alexanderrotariu/tensileTester/README.md

# Tensile Tester 
Collection of files related to 431 Systems Analysis + Design's tensile strength project

The system will preform tensile material strength tests for the UAlbany Chemistry Dept.

The project is based off this paper : 

Fabrication of an Economical Arduino-Based Uniaxial Tensile Tester
Julien H. Arrizabalaga, Aaron D. Simmons, and Matthias U. Nollert
Journal of Chemical Education 2017 94 (4), 530-533
DOI: 10.1021/acs.jchemed.6b00639

All changes made to the original design are included in the slideshow and Physical Design.

Standalone Matlab App can be used with any .csv file format with CM and Newtons as units listed as so:
6CM , 0N
6.5CM , 0.5N
etc...

Load Slope code adapted from Professor Muckells example. 

# Upgraded Parts List
---------------------------------
[S-Type Load Cell](https://www.amazon.com/Pressure-Force-S-type-Sensor-Cable/dp/B01F6IOW6I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) - $36.99

[Push Pull Force Fixture](https://www.amazon.com/Push-Pull-Fixture-Loading-Capacity-Stainless/dp/B087LXNJ2J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) - $19.95 x 2 
 
[DC motor speed controller](https://www.amazon.com/RioRand-Controller-Efficiency-Generating-Protection/dp/B007TH4EN6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) - $9.99

[12v DC motor with wormdrive gearbox](https://www.amazon.com/dp/B01M8LL502?ref_=cm_sw_r_cp_ud_dp_KBN8Q3NMACPN06GBZWH4) - $18.43

# Software dependencies
---------------------------------
- [Arduino IDE](https://www.arduino.cc/en/software) with [ArduSpreadsheet](https://circuitjournal.com/arduino-serial-to-spreadsheet) plugin: Install both Arduino IDE and ArduSpreadsheet to begin data collection. Open the ArduSpreadsheet plugin **BEFORE** data collection begins.
- [MatLab Data Analysis App](https://github.com/alexanderrotariu/tensileTester/blob/main/Source-Code/StressStrainMatlabApp/StressStrainInstaller.exe): Helpful for analyzing data retrieved after tensile testing. This app is a **one time** install. To operate, follow on screen instructions.
