alexanderrotariu/tensileTester/Presentations/Final Presentation.pdf

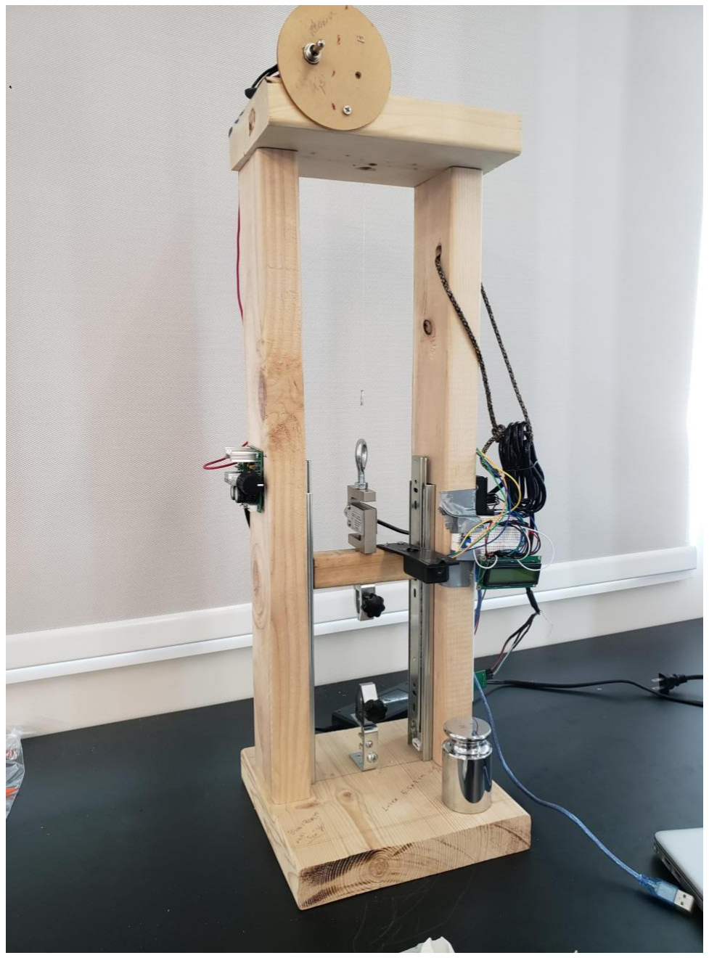
[picture p16: figure]

# Material Tensiometer

Group 8:
Jebadiah Parillo, Alexander Rotariu, Hiroaki Nakahara, Alistair Talaboc

Key Features:(the whats, whys and hows)

Ease-of-use:
- Streamlined data collection system. The device is simple to use and a sample can be taken with just 5 easy steps:
1. Connect PC/laptop via blue USB cable
2. Tighten material in clamps and follow prompts on LCD Screen
3. Toggle motor switch to begin measurements
4. Open ArduSpreadsheet and save data as csv
5. Open Stress Strain matlab app and plot the csv
- Outputs include the Stress-Strain graph, Young’s Modulus and the Ultimate Tensile Strength .
Accuracy:
- Load is automatically calibrated Arduino and then normalized again at the beginning of testing
- Average of 20 values before the device outputs load or distance.

# Budget and Expenses

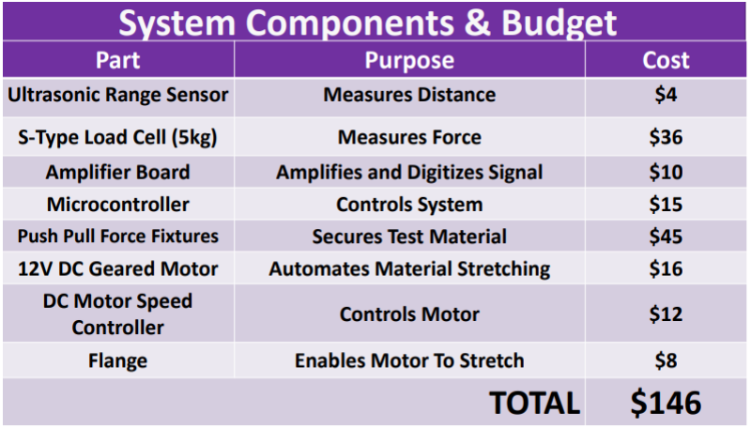
[picture p17: figure]

# Tensiometer Figures:

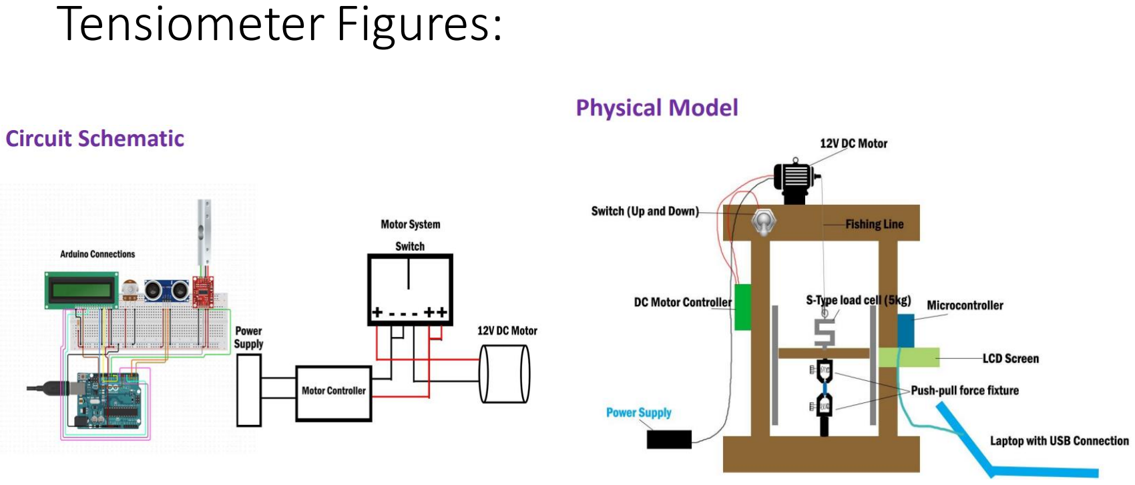
[picture p18: page 4]

# Ease of use survey data:

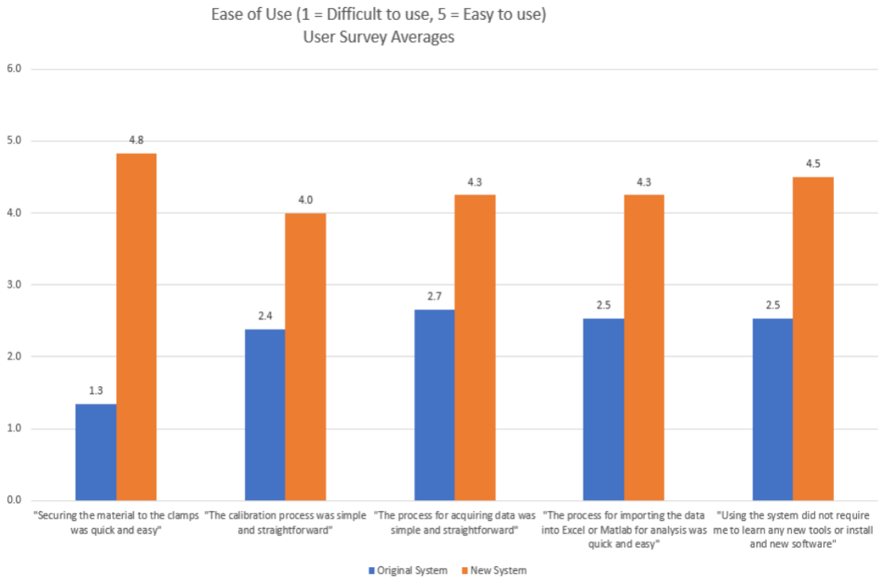
[picture p19: figure]
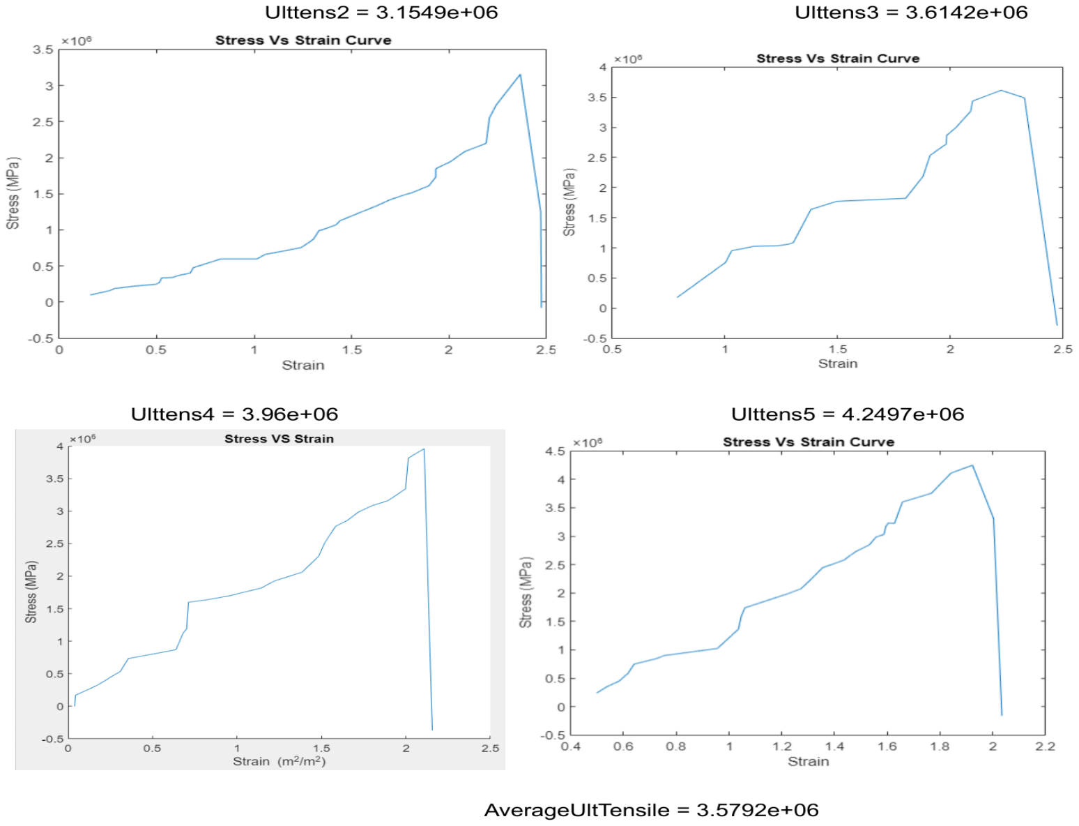
[picture p20: page 6]
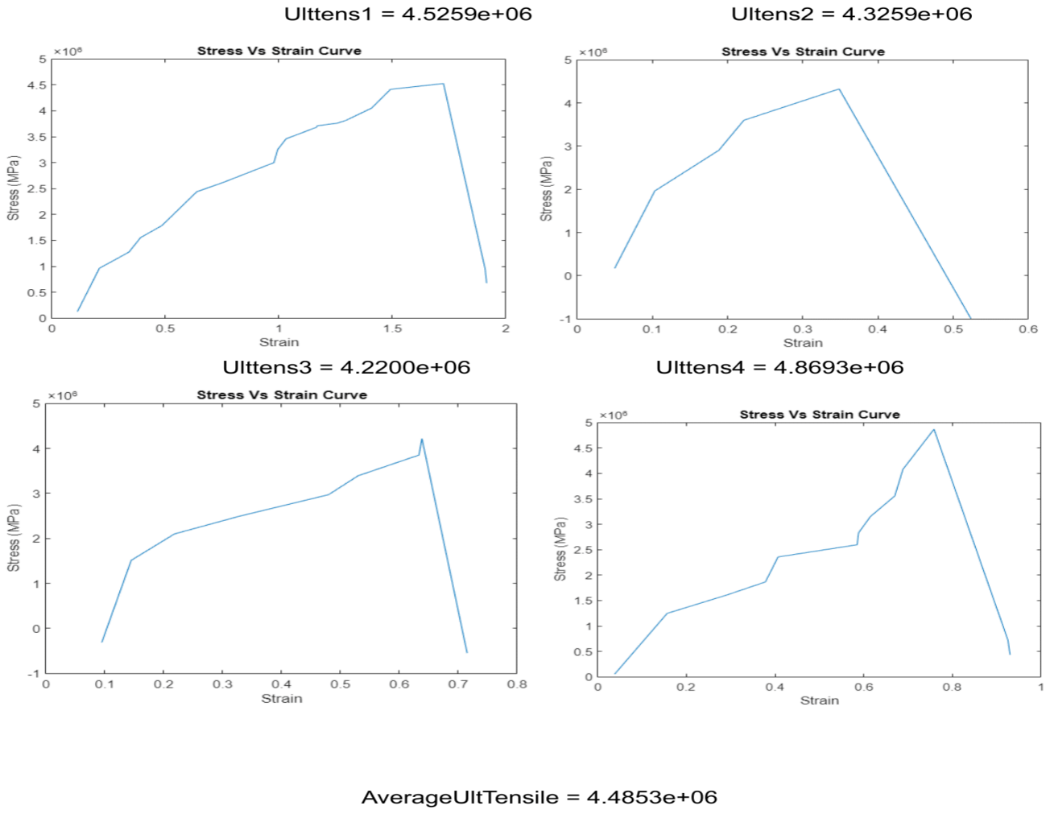
[picture p21: page 7]

System Design Improvements:

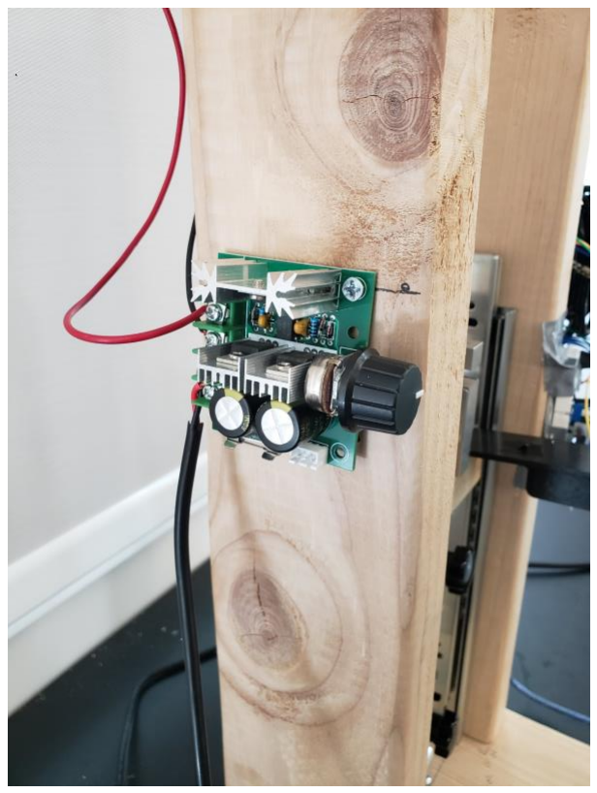
[picture p22: figure]
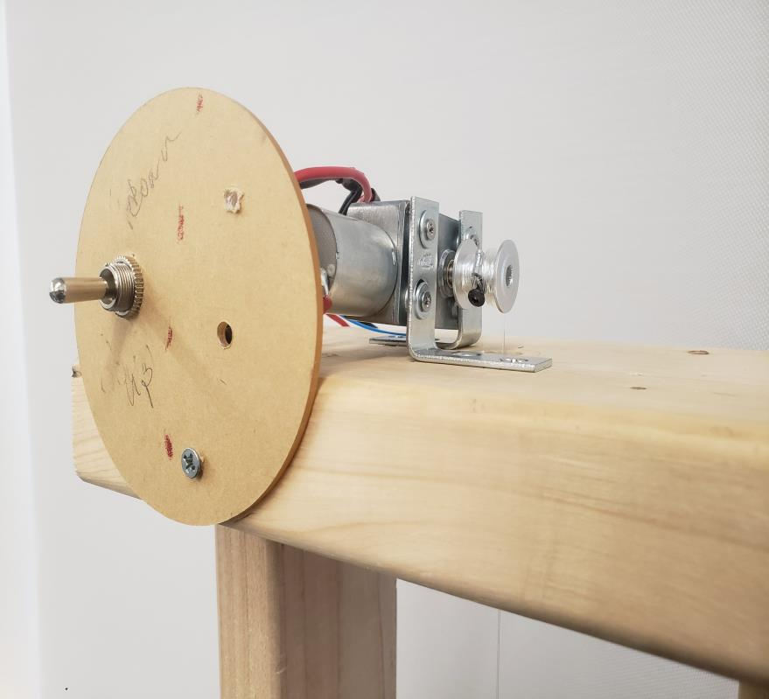
[picture p23: figure]

12V DC Motor with worm
drive gearbox
Driven with a DC Speed
Controller, Up/Down
Switch

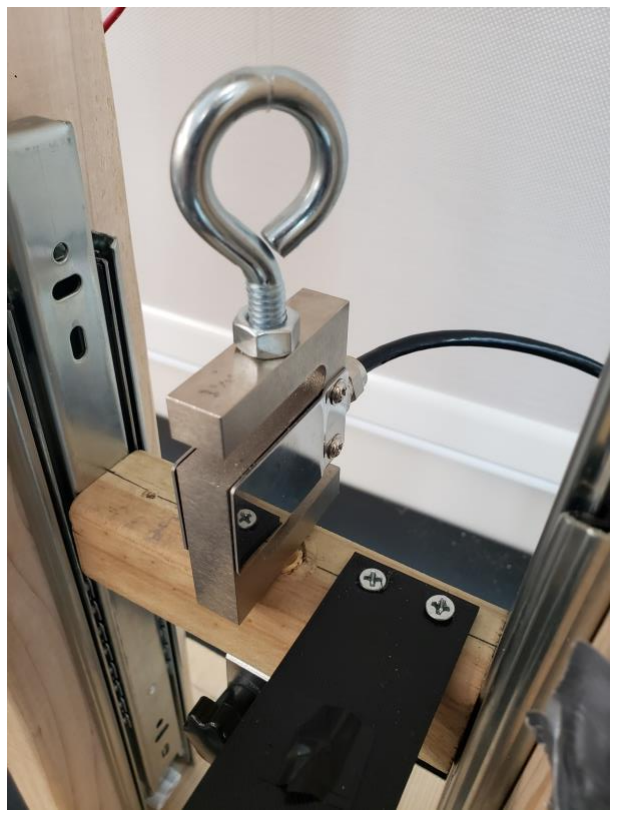
[picture p24: figure]
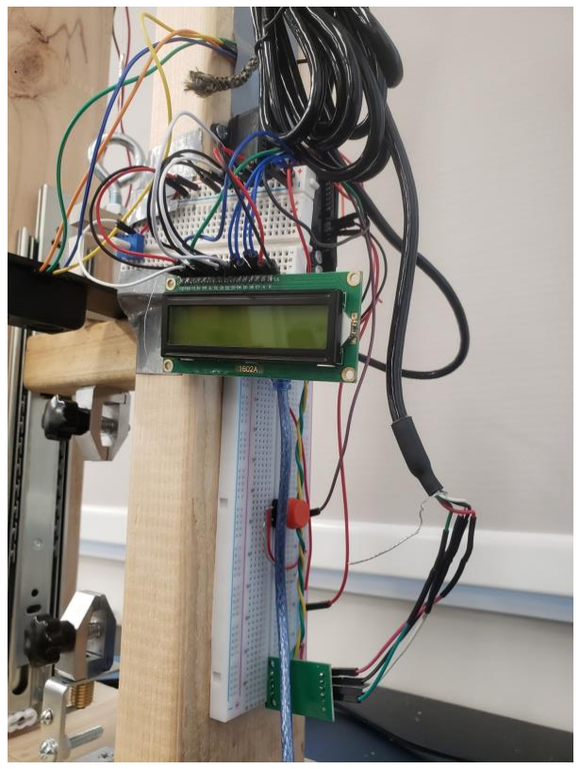
[picture p25: figure]

LCD Screen and button
interface

S

-type Load Cell

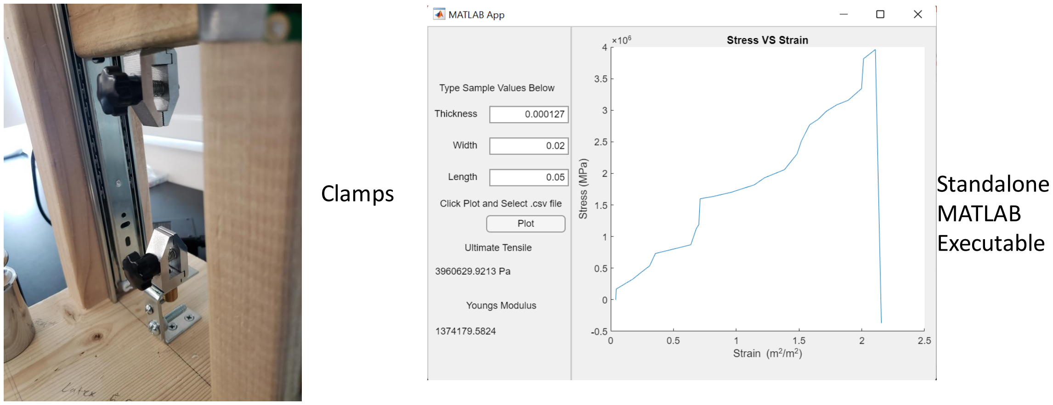
[picture p26: page 10]

Clamps | Standalone MATLAB Executable

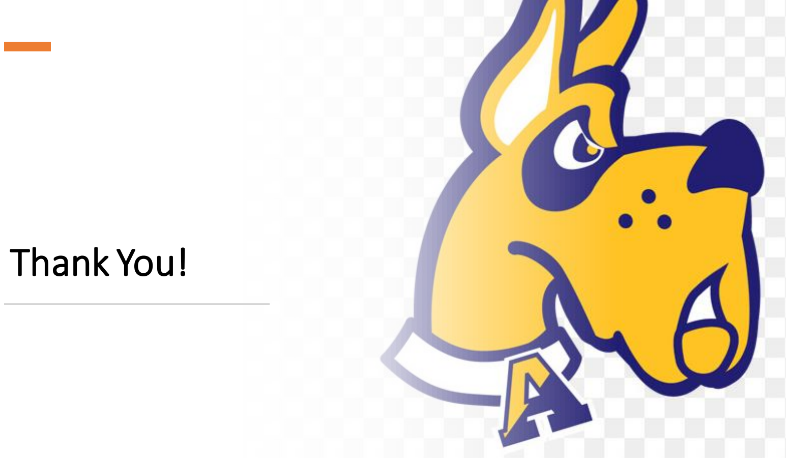
[picture p27: page 11]

# Thank You!
