alexanderrotariu/tensileTester/Reports/Latex Plots.pdf

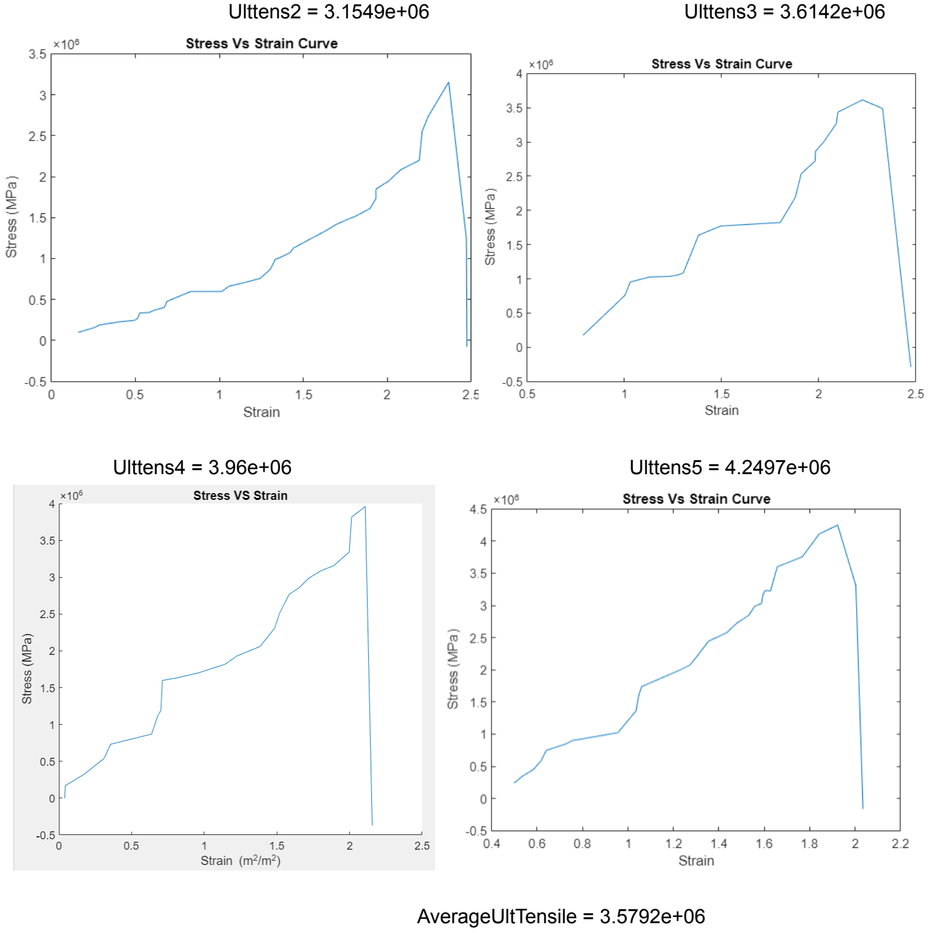
[picture p28: page 1]

Ulttens2 = 3.1549e+06 | Ulttens3 = 3.6142e+06
Ulttens4 = 3.96e+06 | Ulttens5 = 4.2497e+06

AverageUltTensile = 3.5792e+06
