alexanderrotariu/tensileTester/Reports/Nitrile Plots.pdf

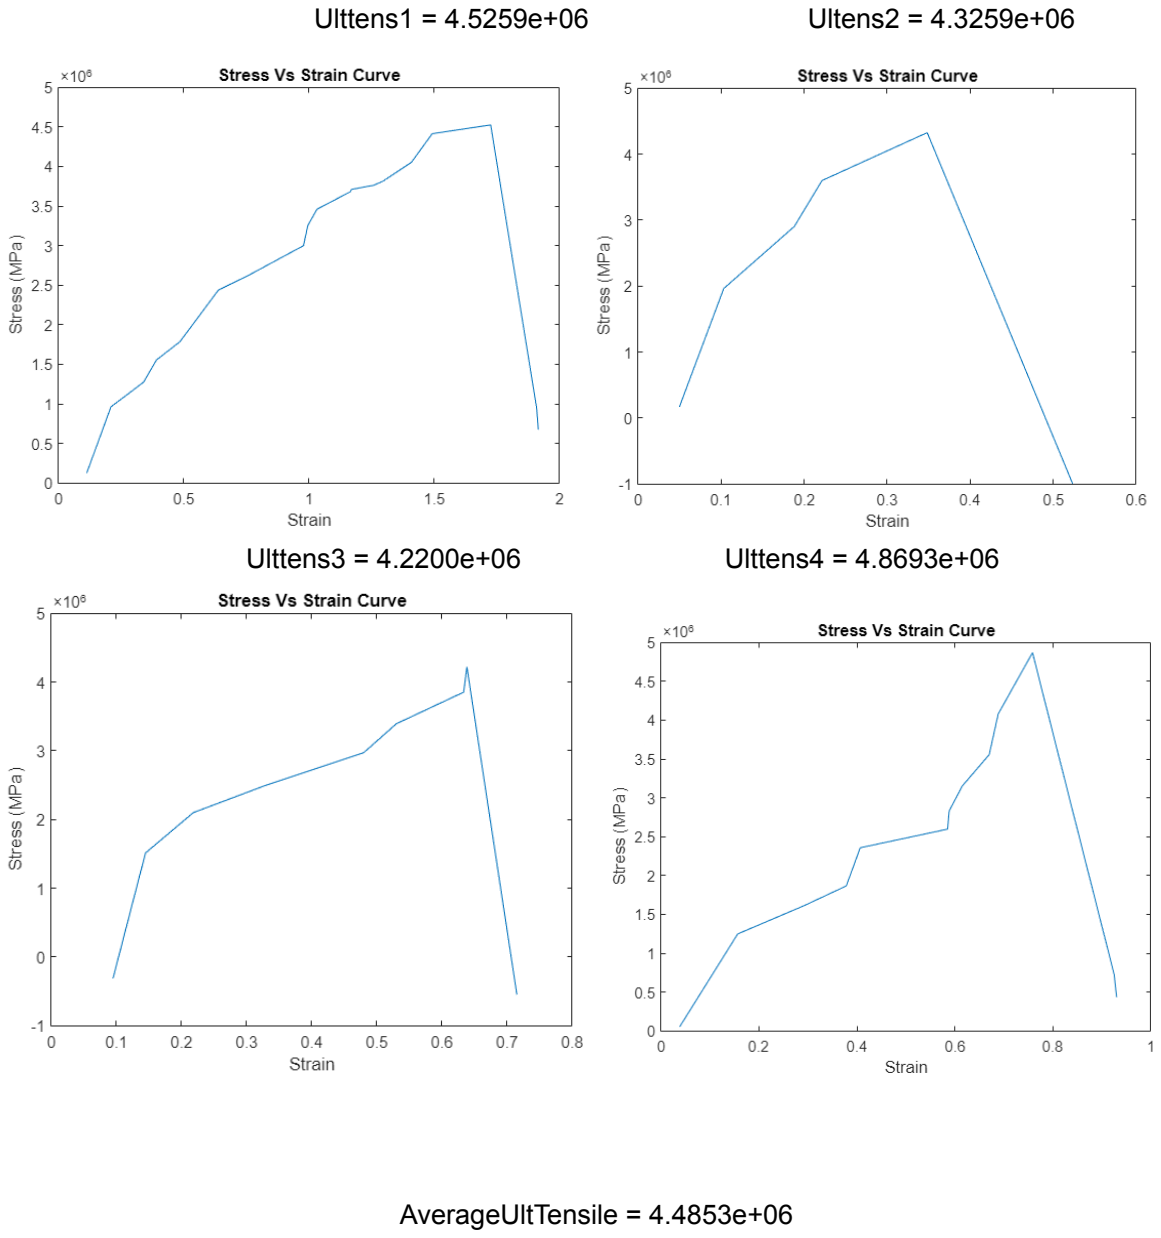
[picture p29: page 1]

Ulttens1 = 4.5259e+06 | Ultens2 = 4.3259e+06
Ulttens3 = 4.2200e+06 | Ulttens4 = 4.8693e+06

AverageUltTensile = 4.4853e+06
