alexanderrotariu/tensileTester/(commit log)

2022-02-11 Add files via upload
    Zip contains initial load cell and ultrasonic sensor data points.
    Also, contains a Matlab script used to analyze said data and its associated excel file.
2022-02-11 inital sensor testing for analysis
    [INIT__ULTRASONIC_TEST.xlsx]
2022-05-02 Milestone7 rework
    [INIT__ULTRASONIC_TEST.xlsx]
